ichoi02/MeowMentum/results/REPORT.md

# Whole-cat score analysis

Generated by `analysis/whole_cat_stats.py`: 72 trials included, 1 excluded (impact before 2.5 m of fall). Each trial is scored at t0 + 0.714 s, the instant of 2.5 m of ballistic fall after free-fall detection. Permutation tests: 5000 permutations, seed 20260819.

## Table II

| Analysis | No tail mean ± SD (n) | With tail mean ± SD (n) | Adjusted tail effect | 95% HC3 CI | HC3 p | Holm-adjusted p | Blocked permutation p |
|---|---|---|---:|---|---:|---:|---:|
| All trials | 0.688 ± 0.155 (37) | 0.798 ± 0.090 (35) | +0.157 | [0.062, 0.252] | 0.0016 | — | 0.0008 |
| Roll sweep | 0.627 ± 0.140 (19) | 0.807 ± 0.086 (17) | +0.185 | [0.075, 0.296] | 0.0019 | 0.0056 | 0.0004 |
| Pitch sweep | 0.715 ± 0.164 (24) | 0.789 ± 0.092 (24) | +0.114 | [-0.057, 0.286] | 0.1841 | 0.3682 | 0.0958 |

- Raw scores: mean ± sample SD (ddof=1), number of trials in parentheses. The adjusted tail effect (with tail minus no tail) is the OLS coefficient after controlling for release condition, collection date, initial whole-cat score and initial angular speed; CI and p use HC3 standard errors with a t reference.
- Holm-adjusted p: Holm over three tests -- the roll sweep, the pitch sweep and the pitch-leveling test in pitch_level_analysis.csv (`p_holm_three_requested` in sweep_results.csv). Holm over the two sweeps alone is `p_holm_two_sweeps`.
- Blocked permutation p: tail labels shuffled within condition x date blocks; only blocks containing both morphologies are used (n_permutation trials).

## All trials: score, components and diagnostics

Adjusted tail effect (with tail minus no tail) from the all-trials ANCOVA. Positive score effects and negative angle/rate effects favor the tail.

| Outcome | Effect | 95% HC3 CI | HC3 p | Holm p (13 outcomes) | Blocked permutation p |
|---|---:|---:|---:|---:|---:|
| coupled whole-cat pose score (0-1) | +0.157 | +0.062 to +0.252 | 0.0016 | 0.0177 | 0.0008 |
| whole-body centerline uprightness (0-1) | +0.021 | -0.024 to +0.067 | 0.3584 | 1.0000 | 0.4897 |
| front/rear attitude alignment (0-1) | +0.162 | +0.066 to +0.258 | 0.0014 | 0.0177 | 0.0002 |
| front-body uprightness score (0-1) | +0.020 | -0.033 to +0.073 | 0.4487 | 1.0000 | 0.3157 |
| rear-body uprightness score (0-1) | +0.080 | +0.021 to +0.139 | 0.0086 | 0.0863 | 0.0168 |
| whole-body centerline tilt (deg) | -3.798 | -12.005 to +4.408 | 0.3584 | 1.0000 | 0.4897 |
| front/rear relative attitude (deg) | -29.156 | -46.519 to -11.793 | 0.0014 | 0.0177 | 0.0002 |
| front-body 3D orientation error (deg) | -6.212 | -15.891 to +3.466 | 0.2042 | 1.0000 | 0.1492 |
| 3D angular speed (deg/s) | -13.676 | -162.710 to +135.358 | 0.8550 | 1.0000 | 0.6961 |
| absolute roll error (deg) | -5.297 | -14.221 to +3.628 | 0.2399 | 1.0000 | 0.2424 |
| absolute pitch error (deg) | +1.607 | -6.836 to +10.049 | 0.7049 | 1.0000 | 0.9206 |
| absolute roll rate (deg/s) | -48.691 | -146.451 to +49.068 | 0.3232 | 1.0000 | 0.2569 |
| absolute pitch rate (deg/s) | +82.972 | -4.169 to +170.112 | 0.0616 | 0.5547 | 0.0720 |

## Sweeps

| Sweep | n | Effect | 95% HC3 CI | HC3 p | Holm p (3 tests) | Holm p (2 sweeps) | Permutation p (n) | 80% MDE |
|---|---:|---:|---:|---:|---:|---:|---:|---:|
| 180-deg roll; pitch 0/15/30/45 deg | 48 | +0.114 | -0.057 to +0.286 | 0.1841 | 0.3682 | 0.1841 | 0.0958 (18) | 0.172 |
| No pitch; roll 45/90/180 deg | 36 | +0.185 | +0.075 to +0.296 | 0.0019 | 0.0056 | 0.0038 | 0.0004 (30) | 0.129 |

## Pitch leveling within the pitch sweep

Final absolute whole-cat fused pitch (0 deg is level, so a negative effect favors the tail), adjusted for condition, date, initial absolute whole-cat pitch and initial angular speed. This is the third member of the Holm family used in Table II.

| Outcome | n | Tail effect | 95% HC3 CI | HC3 p | Holm p (3 tests) | Permutation p (n) |
|---|---:|---:|---:|---:|---:|---:|
| Absolute final whole-cat pitch | 48 | +0.82 deg | -8.43 to +10.08 deg | 0.8582 | 0.8582 | 0.9152 (18) |

## Metric

```text
center_up       = normalize(front_up + rear_up)
U               = 1 - whole_body_tilt / pi
A               = 1 - relative_front_rear_angle / pi
whole_cat_score = U * A
```

The score ranges from 0 to 1. It ignores common yaw, penalizes relative spine twist, and reaches 1 only when the whole-body centerline is upright and the front/rear frames are aligned. The rear body is reconstructed from the front IMU and the spine encoders.

## Limitations

- Tail/no-tail assignment was not randomized or interleaved within collection session; date and morphology are partly confounded.
- The metric was developed after viewing these data. Treat the p-values as exploratory.
- Per-trial provenance (which policy flew each drop, file date labels) is in the 'Data notes' of data/README.md and in data/hardware_trials/MANIFEST.csv. Date is a model term and defines the permutation blocks.

## Excluded trials

- `data/hardware_trials/with_tail/roll/roll_090deg/wt_roll_090deg_0816_rep03.csv`: short_drop: estimated fall distance 2.423 m is below target 2.500 m
