ichoi02/MeowMentum/docs/assets/img/cad.png

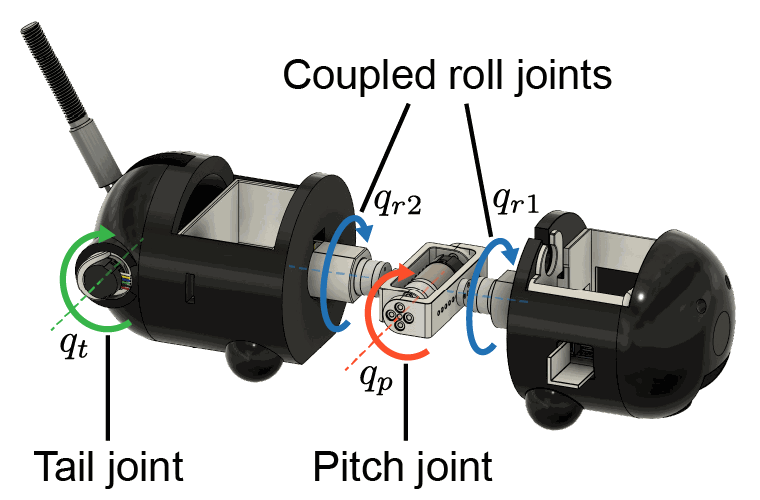
docs/assets/img/cad.png
