ichoi02/MeowMentum/docs/assets/img/cad_rear.png

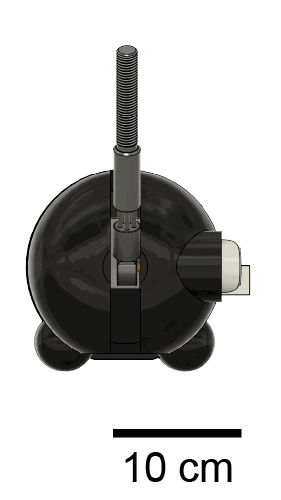
docs/assets/img/cad_rear.png
