ichoi02/MeowMentum/docs/assets/img/method/real_1.jpg

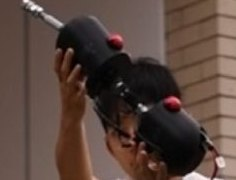
docs/assets/img/method/real_1.jpg
