ichoi02/MeowMentum/docs/assets/img/method/real_2.jpg

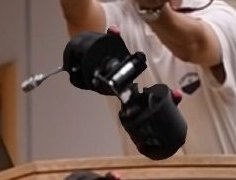
docs/assets/img/method/real_2.jpg
