ichoi02/MeowMentum/docs/assets/img/method/real_3.jpg

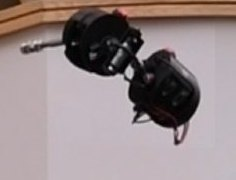
docs/assets/img/method/real_3.jpg
