ichoi02/MeowMentum/docs/assets/img/method/real_4.jpg

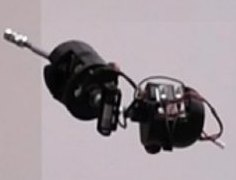
docs/assets/img/method/real_4.jpg
