ichoi02/MeowMentum/docs/assets/img/method/real_5.jpg

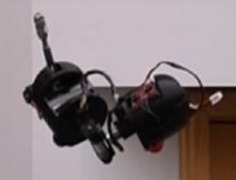
docs/assets/img/method/real_5.jpg
