ichoi02/MeowMentum/docs/assets/img/method/real_6.jpg

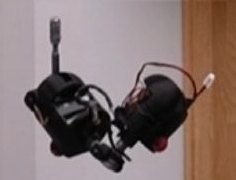
docs/assets/img/method/real_6.jpg
