ichoi02/MeowMentum/docs/assets/img/method/sim_1.jpg

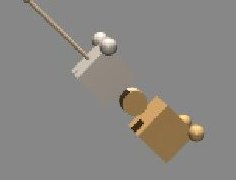
docs/assets/img/method/sim_1.jpg
