ichoi02/MeowMentum/docs/assets/img/method/sim_2.jpg

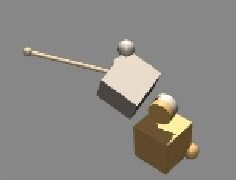
docs/assets/img/method/sim_2.jpg
