ichoi02/MeowMentum/docs/assets/img/method/sim_3.jpg

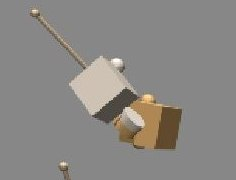
docs/assets/img/method/sim_3.jpg
