ichoi02/MeowMentum/docs/assets/img/method/sim_4.jpg

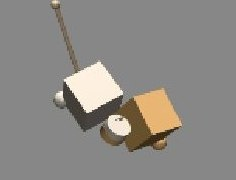
docs/assets/img/method/sim_4.jpg
