ichoi02/MeowMentum/docs/assets/img/method/sim_5.jpg

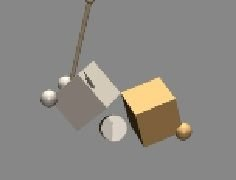
docs/assets/img/method/sim_5.jpg
