ichoi02/MeowMentum/docs/assets/img/method/sim_6.jpg

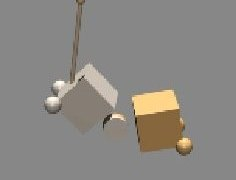
docs/assets/img/method/sim_6.jpg
