ichoi02/MeowMentum/docs/assets/img/method/thumb_robot.jpg

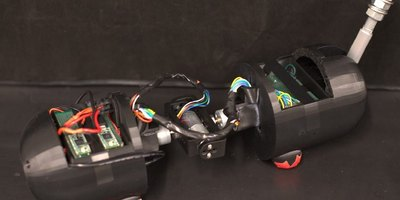
docs/assets/img/method/thumb_robot.jpg
