ichoi02/MeowMentum/docs/assets/img/method/thumb_sim.jpg

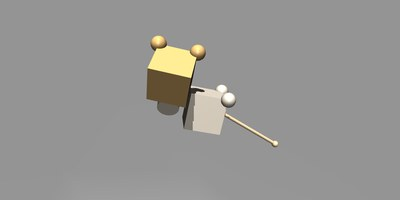
docs/assets/img/method/thumb_sim.jpg
