ichoi02/MeowMentum/docs/assets/img/og.jpg

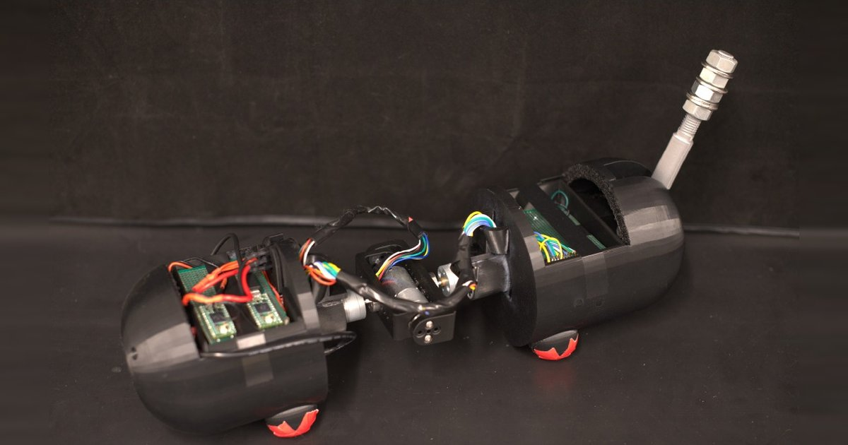
docs/assets/img/og.jpg
