ichoi02/MeowMentum/docs/assets/img/sim_vs_real.jpg

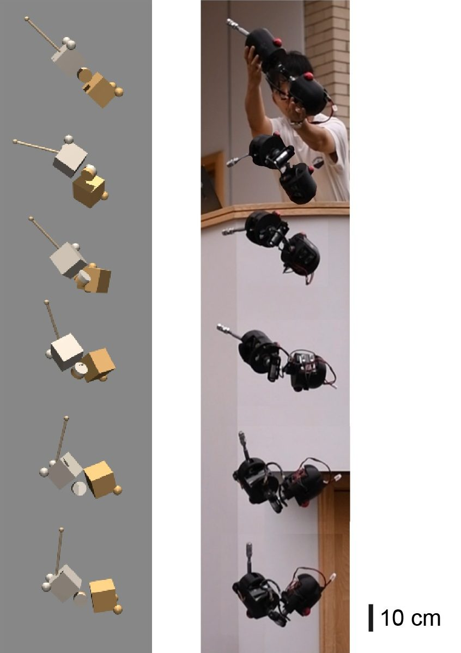
docs/assets/img/sim_vs_real.jpg
