ichoi02/MeowMentum/docs/assets/video/hero.jpg

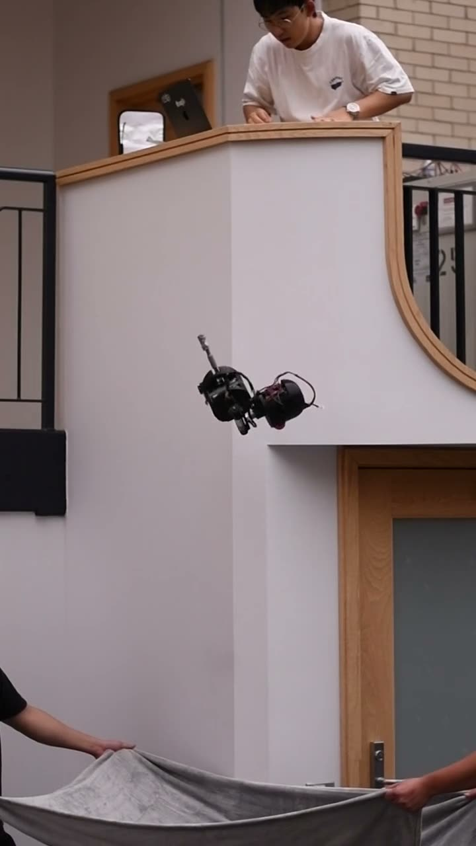
docs/assets/video/hero.jpg
