ichoi02/MeowMentum/docs/assets/video/roll45_notail.jpg

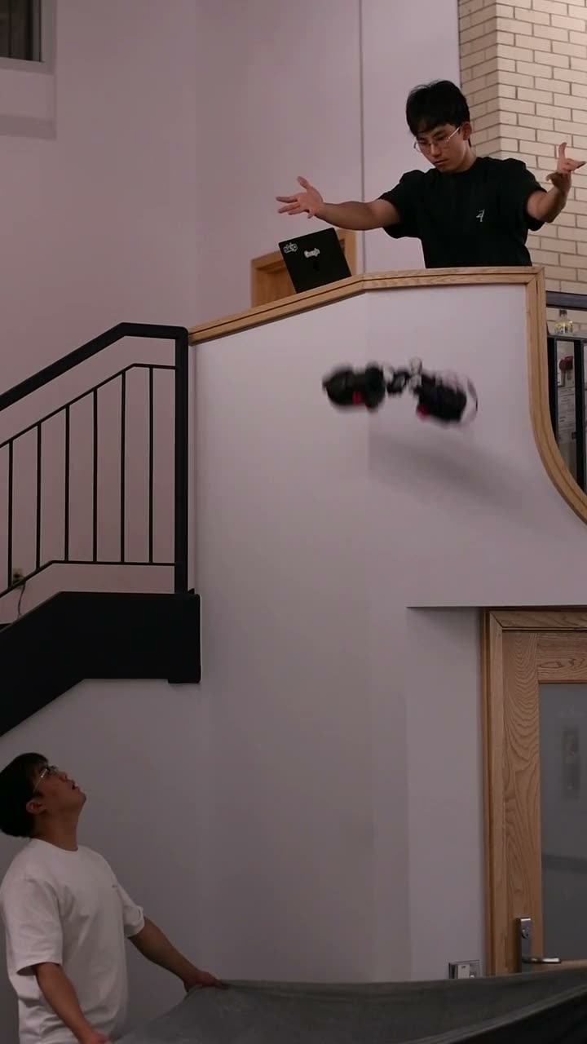
docs/assets/video/roll45_notail.jpg
