ichoi02/MeowMentum/docs/assets/video/roll45_tail.jpg

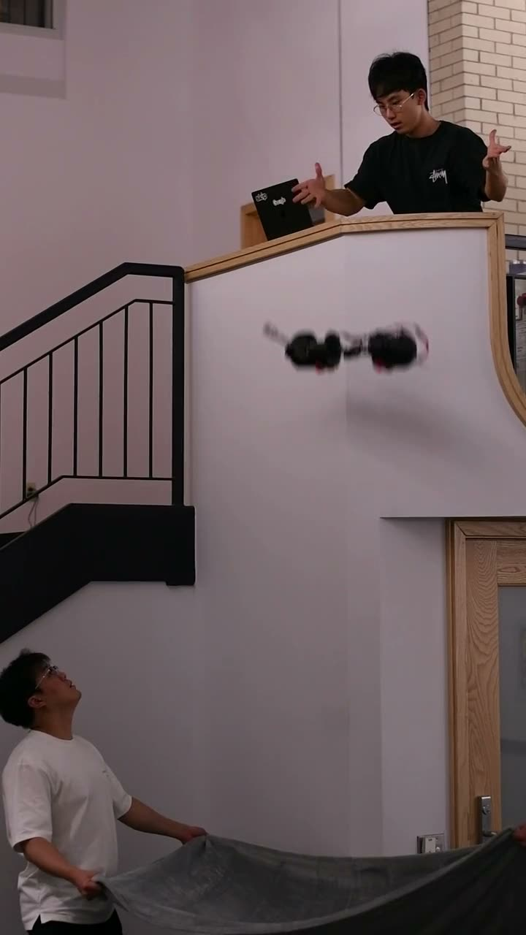
docs/assets/video/roll45_tail.jpg
