ichoi02/MeowMentum/docs/assets/video/roll180_notail.jpg

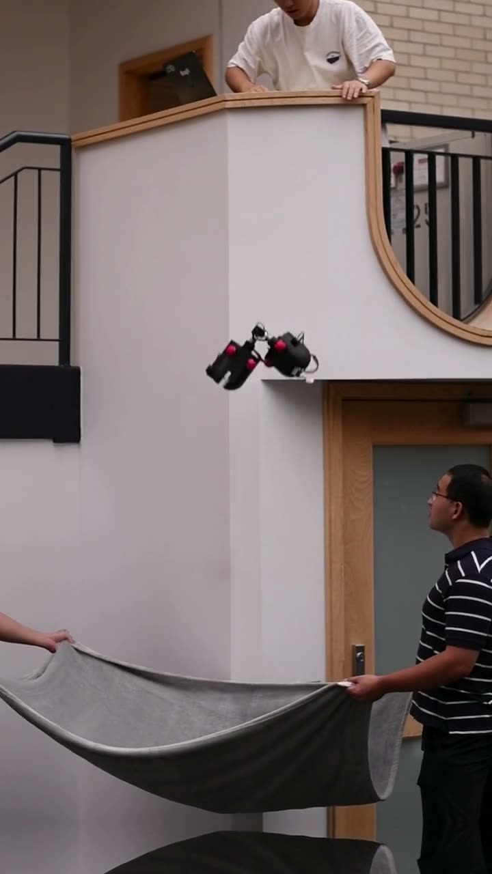
docs/assets/video/roll180_notail.jpg
