ichoi02/MeowMentum/docs/assets/video/roll180_pitch15_notail.jpg

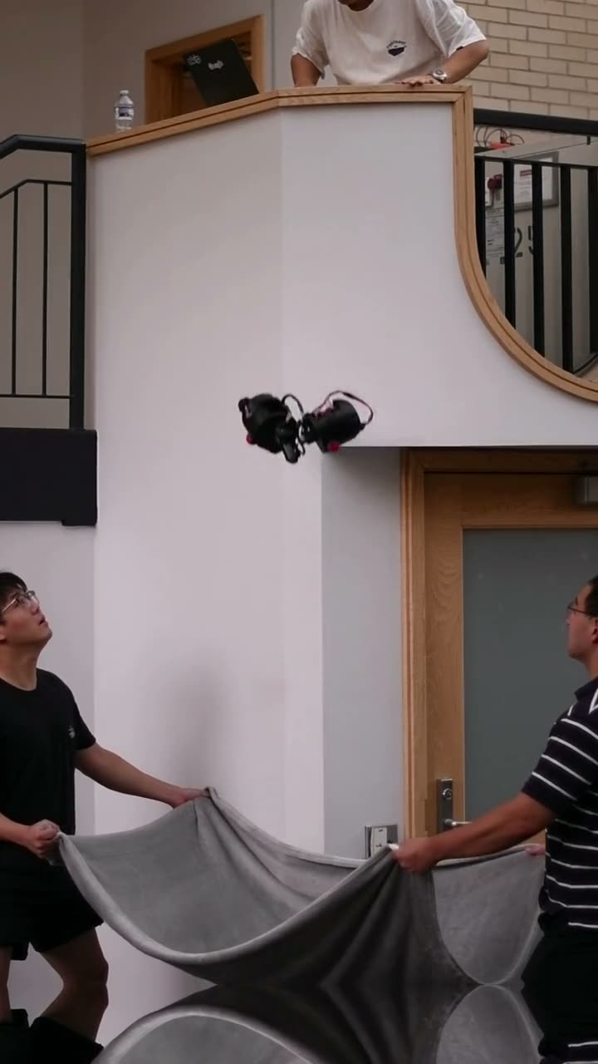
docs/assets/video/roll180_pitch15_notail.jpg
