ichoi02/MeowMentum/docs/assets/video/roll180_pitch15_tail.jpg

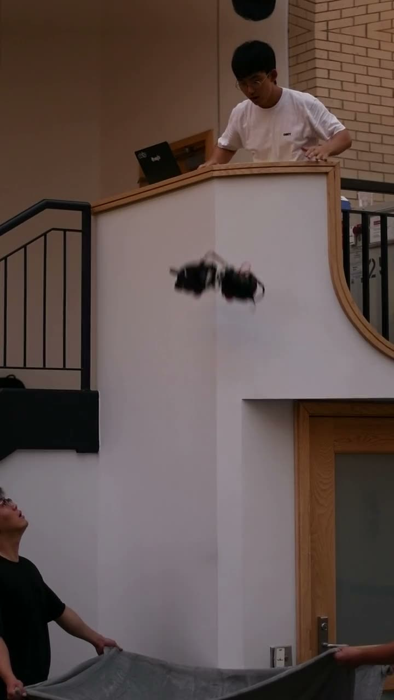
docs/assets/video/roll180_pitch15_tail.jpg
