ichoi02/MeowMentum/docs/assets/video/roll180_pitch45_notail.jpg

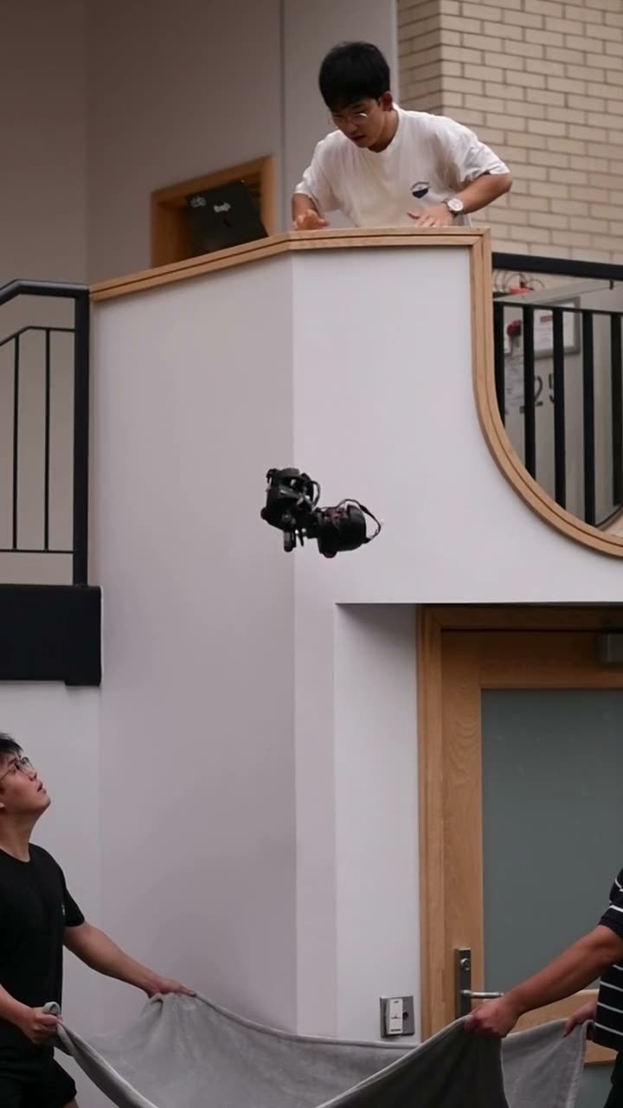
docs/assets/video/roll180_pitch45_notail.jpg
