ichoi02/MeowMentum/docs/assets/video/roll180_pitch45_tail.jpg

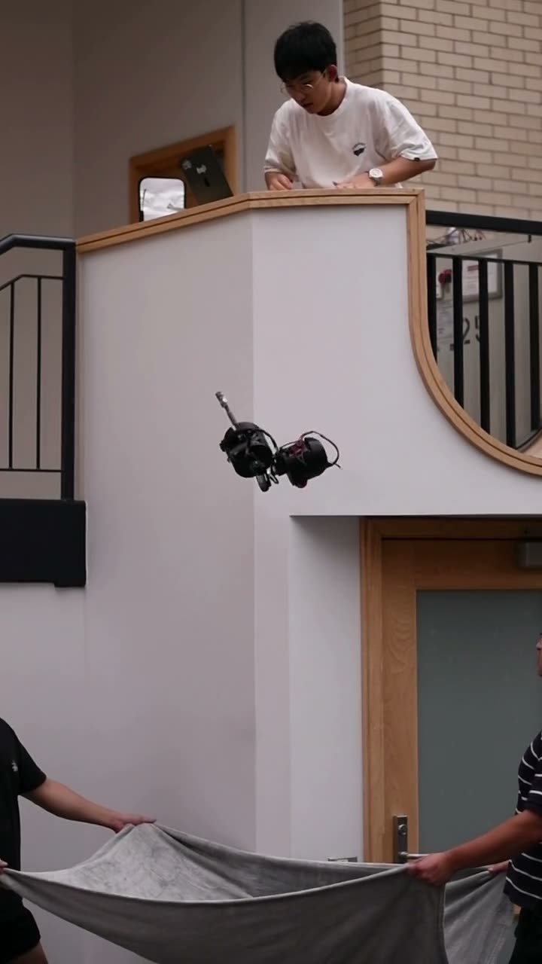
docs/assets/video/roll180_pitch45_tail.jpg
