ichoi02/MeowMentum/docs/assets/video/roll180_tail.jpg

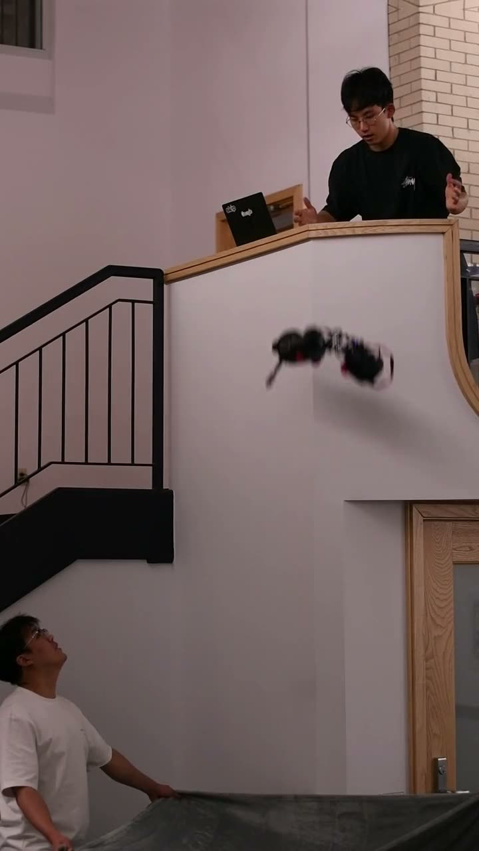
docs/assets/video/roll180_tail.jpg
