ichoi02/MeowMentum/results/pitch_level_analysis.csv

analysis | label | conditions | n | estimate | se_hc3 | ci_low | ci_high | t_hc3 | p_hc3 | residual_sd | df_resid | estimate_no_date | p_no_date | overlap_estimate | p_permutation | n_overlap | p_holm_three_requested
pitch_leveling_at_roll_180 | Final absolute whole-cat pitch; roll 180, pitch 0/15/30/45 deg | r180,r180_p15,r180_p30,r180_p45 | 48 | 0.8229629778973736 | 4.575220108683007 | -8.431293193105345 | 10.077219148900094 | 0.17987396416962032 | 0.8581828742134057 | 9.913451513301482 | 39 | 2.6119586691286054 | 0.41631847920955567 | 0.5209777881644695 | 0.9152169566086783 | 18 | 0.8581828742134057
