ichoi02/MeowMentum/results/model_results.csv

outcome | label | estimate | se_hc3 | ci_low | ci_high | t_hc3 | p_hc3 | residual_sd | df_resid | estimate_no_date | p_no_date | overlap_estimate | p_permutation | n_overlap | p_holm_all_outcomes
posture_score | coupled whole-cat pose score (0-1) | 0.15707271107838075 | 0.0475397455456118 | 0.06201111466071728 | 0.2521343074960442 | 3.3040292764646377 | 0.001598227229355881 | 0.12379917061292364 | 61 | 0.11247398602451908 | 0.001687374954775951 | 0.16893397069534388 | 0.0007998400319936012 | 42 | 0.01765017887485211
whole_body_upright_score | whole-body centerline uprightness (0-1) | 0.02110124686405261 | 0.022799917151970307 | -0.02449000520895786 | 0.06669249893706308 | 0.9254966464748359 | 0.3583546748359252 | 0.06172640689424315 | 61 | 0.0022589900027973134 | 0.8846156143106014 | 0.01557241837094852 | 0.4897020595880824 | 42 | 1.0
spine_alignment_score | front/rear attitude alignment (0-1) | 0.16197778772301807 | 0.04823948641862986 | 0.06551697295228275 | 0.2584386024937534 | 3.357784249967948 | 0.001357706067302287 | 0.11386908619187594 | 61 | 0.1279698127799442 | 0.000364630816635944 | 0.17993412006672935 | 0.0001999600079984003 | 42 | 0.01765017887485211
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
