ichoi02/MeowMentum/results/sweep_results.csv

sweep | label | conditions | n | estimate | se_hc3 | ci_low | ci_high | t_hc3 | p_hc3 | residual_sd | df_resid | estimate_no_date | p_no_date | overlap_estimate | p_permutation | n_overlap | mde_80 | p_holm_two_sweeps | p_permutation_holm_two_sweeps | p_holm_three_requested
pitch_sweep_at_roll_180 | 180-deg roll; pitch 0/15/30/45 deg | r180,r180_p15,r180_p30,r180_p45 | 48 | 0.11441751463513823 | 0.08461143013881856 | -0.05672525683797476 | 0.28556028610825124 | 1.3522701891153244 | 0.1840786449796144 | 0.13155749790725635 | 39 | 0.07796540101547442 | 0.0712523158516107 | 0.15039219589413727 | 0.09578084383123375 | 18 | 0.17160101207239925 | 0.1840786449796144 | 0.09578084383123375 | 0.3681572899592288
no_pitch_roll_sweep | No pitch; roll 45/90/180 deg | r45,r90,r180 | 36 | 0.18549162003734498 | 0.054045706380428146 | 0.07478400910430717 | 0.2961992309703828 | 3.432125000488809 | 0.001879901382183328 | 0.12013620798154706 | 28 | 0.18906220141345378 | 0.0003282013214644886 | 0.19496698610617821 | 0.0003999200159968006 | 30 | 0.12880395612975476 | 0.003759802764366656 | 0.0007998400319936012 | 0.005639704146549984
