ichoi02/MeowMentum/results/table2.csv

analysis | conditions | n_no_tail | mean_no_tail | sd_no_tail | n_with_tail | mean_with_tail | sd_with_tail | tail_effect | ci_low | ci_high | p_hc3 | p_holm | p_permutation | n_permutation | df_resid
All trials | r45,r90,r180,r180_p15,r180_p30,r180_p45 | 37 | 0.6881138889610692 | 0.15511519994738296 | 35 | 0.7981288215565862 | 0.09033739148324733 | 0.15707271107838075 | 0.06201111466071728 | 0.2521343074960442 | 0.001598227229355881 |  | 0.0007998400319936012 | 42 | 61
Roll sweep | r45,r90,r180 | 19 | 0.6272852135410402 | 0.1396281934802958 | 17 | 0.8074681895487186 | 0.08585565180871357 | 0.18549162003734498 | 0.07478400910430717 | 0.2961992309703828 | 0.001879901382183328 | 0.005639704146549984 | 0.0003999200159968006 | 30 | 28
Pitch sweep | r180,r180_p15,r180_p30,r180_p45 | 24 | 0.7153764326368801 | 0.1636388886473648 | 24 | 0.789469563295856 | 0.09161434896892498 | 0.11441751463513823 | -0.05672525683797476 | 0.28556028610825124 | 0.1840786449796144 | 0.3681572899592288 | 0.09578084383123375 | 18 | 39
