ichoi02/MeowMentum/results/tilt_milestones.csv

morphology | body | depth_m | time_s | n | mean_deg | sd_pop_deg | sd_sample_deg | covered
with_tail | mean | 1.0 | 0.4515236409857309 | 36 | 42.296303968471165 | 22.544546945849618 | 22.864343726653907 | True
with_tail | mean | 2.0 | 0.638550856814101 | 36 | 29.581373553454018 | 14.241220932316976 | 14.443234156171803 | True
no_tail | mean | 1.0 | 0.4515236409857309 | 37 | 51.21795617108208 | 24.72427949651377 | 25.065320151669084 | True
no_tail | mean | 2.0 | 0.638550856814101 | 37 | 35.5837085199183 | 18.249700757918117 | 18.501432659903227 | True
