ichoi02/MeowMentum/(commit log)

2026-10-09 Import deployed code, policies, and hardware trial data
    Verbatim snapshot of what flew in the Aug 10/16/17 2026 drop experiments,
    with no history from the development branches:
    - Sim, training, distillation, ONNX export and hardware code from
    sim2real-v2 @ 317d456. This is byte-identical to the Raspberry Pi
    snapshot on branch 'final' (755ed43).
    - docs/evaluate.py has moved to evaluate.py.
    - Deployed policies: the av002 SAC teachers (2026-08-08 13:36), the DAgger
    students (13:49/13:50) and their ONNX exports.
    - The 73 hardware drop logs, byte-identical to raw/ in the working tree.
    - TensorBoard logs of the two deployed teacher runs.
    - Analysis scripts taken verbatim: raw/{plot,control_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
2026-10-09 Clean up for release: defaults, docs, analysis package, verification tools
    Simulation and training
    - Reward defaults now reproduce the released "av002" teachers: task term
    1.5*(0.5*(u_f+u_r) + u_f*u_r), w_av = 0.002, w_en = w_jv = w_time = 0.
    The committed penalty vector had never trained a deployed policy. An env
    equivalence test against the original code (run with the CAT_W_* overrides)
    is bitwise identical over 6000 steps.
    - Model paths resolve relative to the package, so every script runs from any
    working directory.
    - Lab-notebook comments that referenced removed sweep files are replaced with
    concise, accurate ones. Dead helpers and legacy frame stacking are removed.
    - Smooth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
2026-10-09 Add project page (GitHub Pages, docs/)
    A static, build-free page in docs/ to serve with GitHub Pages from /docs.
    - Hero with a cropped slow-motion drop, a one-paragraph summary of the result,
    and links.
    - Synchronized with/without-tail clip pairs for four release conditions, encoded
    as upright 24 fps H.264 at about 250 KB each.
    - Robot, CAD and sim-vs-hardware figures from the paper; a pipeline summary;
    the momentum equation; the domain randomisation table.
    - A three.js replay of any of the 73 hardware drops, rebuilt from the onboard
    telemetry with the MuJoCo joint chain. It shows impact timing, the policy that
    flew each drop (identified by log replay), and simulated rollouts of th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
2026-10-09 Project page: end hardware replays exactly at impact
    Playback, the scrubber, the HUD and the mini chart now stop at the impact
    sample. That sample is the accelerometer peak in the blanket, 0.70-0.85 s
    after free-fall detection. The post-landing samples logged after it are no
    longer shown. Simulated rollouts have no landing and still run the full
    episode.
2026-10-09 Project page: target arrows in the replay, Method figure, trimmed hero
    - Replay: the joint rings are replaced by thin arcs around each joint axis,
    drawn from the measured angle to the commanded target (larger radius,
    thinner stroke). Hardware targets come from the logged Cmd_* columns and sim
    targets from the env. page-data.js gains a per-sample "c" field.
    - Method: the four-stage cards, the momentum and reward equations and the
    randomisation table are replaced by one figure. It combines a pipeline diagram
    (MuJoCo render, teacher, student, robot, with the DAgger loop) with the paper's
    sim-vs-hardware snapshots rearranged as a two-row filmstrip.
    - The Discussion section is removed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
2026-10-09 Project page: sync the robots' height in the Drops clip pairs
    The comparison clips are re-cut from the 1080p sources so that, within each
    pair, both robots sit at the same screen height in every frame from release to
    the first landing:
    - The robot is tracked per frame.
    - Both clips are cropped to the same pixels per metre (calibrated on fixed
    architecture), with the release points placed at the same output height.
    - The faster-falling clip sets the timing; the other skips source frames to
    match fallen distance, so nothing repeats.
    - Where a crop runs past the source frame, the strip is mirror-filled.
    The measured height gap between the two robots in the encoded files is a median
    of 3-5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
2026-10-10 Project page: replay arrows, end at 2.5 m, orbit lag fix
    - Remove the Drop data button from the title section.
    - Replay: joint arrows in the CAD figure's colours, front roll arrow
    turning the same way as the rear one, no release-pose outline,
    default drop roll 180 / pitch 30 / drop 1, subtitle, page font.
    - Every replay ends after 2.5 m of fall; the few drops that touch the
    blanket earlier end at their last pre-contact sample (impact_t).
    - Fix render loops multiplying after each orbit drag.
2026-10-10 Project page: abstract as a dropdown bar under the hero buttons
    The Abstract section and its nav link are gone. The abstract now opens
    from a small bar below Code and Paper, as a panel over the content
    below, so the hero never shifts. It closes on Escape or an outside click.
